Fortinbra/CHIRBot/host/chirbot-cli/README.md

# chirbot-cli

> **Status:** planned — no code yet.

Command-line tooling for CHIRBot, aimed at scripting and CI:

- Device configuration and firmware/asset management from scripts
- TASD file inspection, validation, and conversion
- Automated test harness support (streaming recorded input, capturing output)

See [docs/ARCHITECTURE.md](../../docs/ARCHITECTURE.md).
