Fortinbra/CHIRBot/firmware/modules/input-usb/README.md

# input-usb

> **Status:** planned — no code yet.

USB host input module (PIO-based USB host on RP2350B). Reads native USB
controllers and forwards input as TASD-packetized SPI data to the core.

Target devices include Xbox 360/PS3 controllers, wired Switch Pro controllers,
and accessibility hardware such as the Xbox Adaptive Controller and the Sony
PlayStation Access controller.

See [firmware/modules/README.md](../README.md) and
[docs/ARCHITECTURE.md](../../../docs/ARCHITECTURE.md).
