Fortinbra/CHIRBot/docs/ROADMAP.md

# CHIRBot roadmap

> **Status:** Working plan. Ordering may change as prototypes invalidate
> assumptions; accepted technical choices belong in [design decisions](design/).

The immediate goal is not to implement every planned component. It is to prove
one complete input-to-output path, exercise it on real hardware, and capture
the gotchas that shape the contracts for later modules. Performance targets are
measurements and follow-up work during this phase, not gates that block basic
integration.

## 0. Align the project baseline

- [ ] Update chirbot.com to reflect RP2350B, the passive module carrier, and
      board-to-board module slots;
      keep the longer design discussions as clearly labeled historical context
- [ ] Choose hardware, documentation, and contribution licenses explicitly
- [ ] Add contribution and security guidance before inviting broad contributions
- [ ] Establish lightweight CI for documentation links and the TASD host tests

## 1. Stabilize shared interfaces

- [ ] Define the [module interface](specs/README.md): connector pinout, power
      budget, mechanical envelope, retention, power-off-only/hot-swap policy,
      module descriptor fields, shared SPI/I2C rules, and per-slot CS/IRQ
- [ ] Define the [SPI matrix protocol](specs/README.md): framing, transactions,
      core-initiated discovery, descriptor encoding, data-ready service,
      capabilities, version negotiation, error handling, and timing
- [ ] Define CHIRBot's [TASD usage](specs/README.md), separating live transport
      needs from file-storage semantics
- [ ] Define the [clock-domain model](specs/README.md), including output poll
      edges, buffering, timestamps, and recording behavior
- [ ] Record the approximately 1 ms objective and the measurements needed to
      turn it into a later latency budget; do not make the final budget a PoC
      entry gate

## 2. Prove one vertical slice

- [ ] Select the simplest representative input/core/output combination
- [ ] Build a host-testable `chirbot-common` framing and handshake library
- [ ] Build the [three-MCU architecture prototype](../hardware/PROTOTYPE.md)
      using an RP2350B core and two modules on development hardware
- [ ] Demonstrate live relay, recording, and playback through the same path
- [ ] Verify the complete path, startup/reset behavior, link recovery, and
      replay behavior on real hardware
- [ ] Capture electrical margins, wiring mistakes, signal-integrity issues,
      and other hardware gotchas as prototype findings
- [ ] Measure latency and jitter as characterization data; optimize and enforce
      targets after the integration path is stable
- [ ] Feed prototype findings back into specs and superseding ADRs

NES/SNES is a strong candidate for this milestone because its signaling and
poll edge are well understood, but that selection should be recorded before
implementation begins.

## 3. Productize the proven path

- [ ] Design the core and first module PCBs from the stabilized interface
- [ ] Select a carrier topology for boot-selected dual-role modules, then
      design and validate the passive carrier PCB
- [ ] Add repeatable firmware builds, tests, release artifacts, and flashing docs
- [ ] Implement the minimum host configuration and TASD inspection workflow
- [ ] Validate cost targets with sourced BOMs and small production quantities
- [ ] Document assembly, enclosure, recovery, and troubleshooting workflows

## 4. Expand deliberately

- [ ] Add modules one protocol family at a time using the stable shared contracts
- [ ] Add visualization and richer host application workflows
- [ ] Propose required rumble and motion extensions upstream to TASD
- [ ] Promote components to standalone repositories only when independent
      versioning, releases, or ownership provide a concrete benefit

## Definition of baseline readiness

The project has a credible PoC baseline when one end-to-end hardware path is
repeatable, its startup and recovery behavior are understood, important
electrical and integration gotchas are recorded, and the build and focused
tests run. Meeting the final timing budget, production contracts, and module
authoring experience are productization milestones built on that baseline.
