Fortinbra/CHIRBot/tools/README.md

# tools/

Project-wide development tooling: build/CI helpers, code generation, release
scripts, and other utilities that span multiple components.

> **Status:** empty — tooling is added as needs emerge.
