Fortinbra/CHIRBot/hardware/chirbot-core-hw/CHIRBot Core.kicad_sch

## KiCad design hardware/chirbot-core-hw/CHIRBot Core.kicad_sch (2026-10-18)

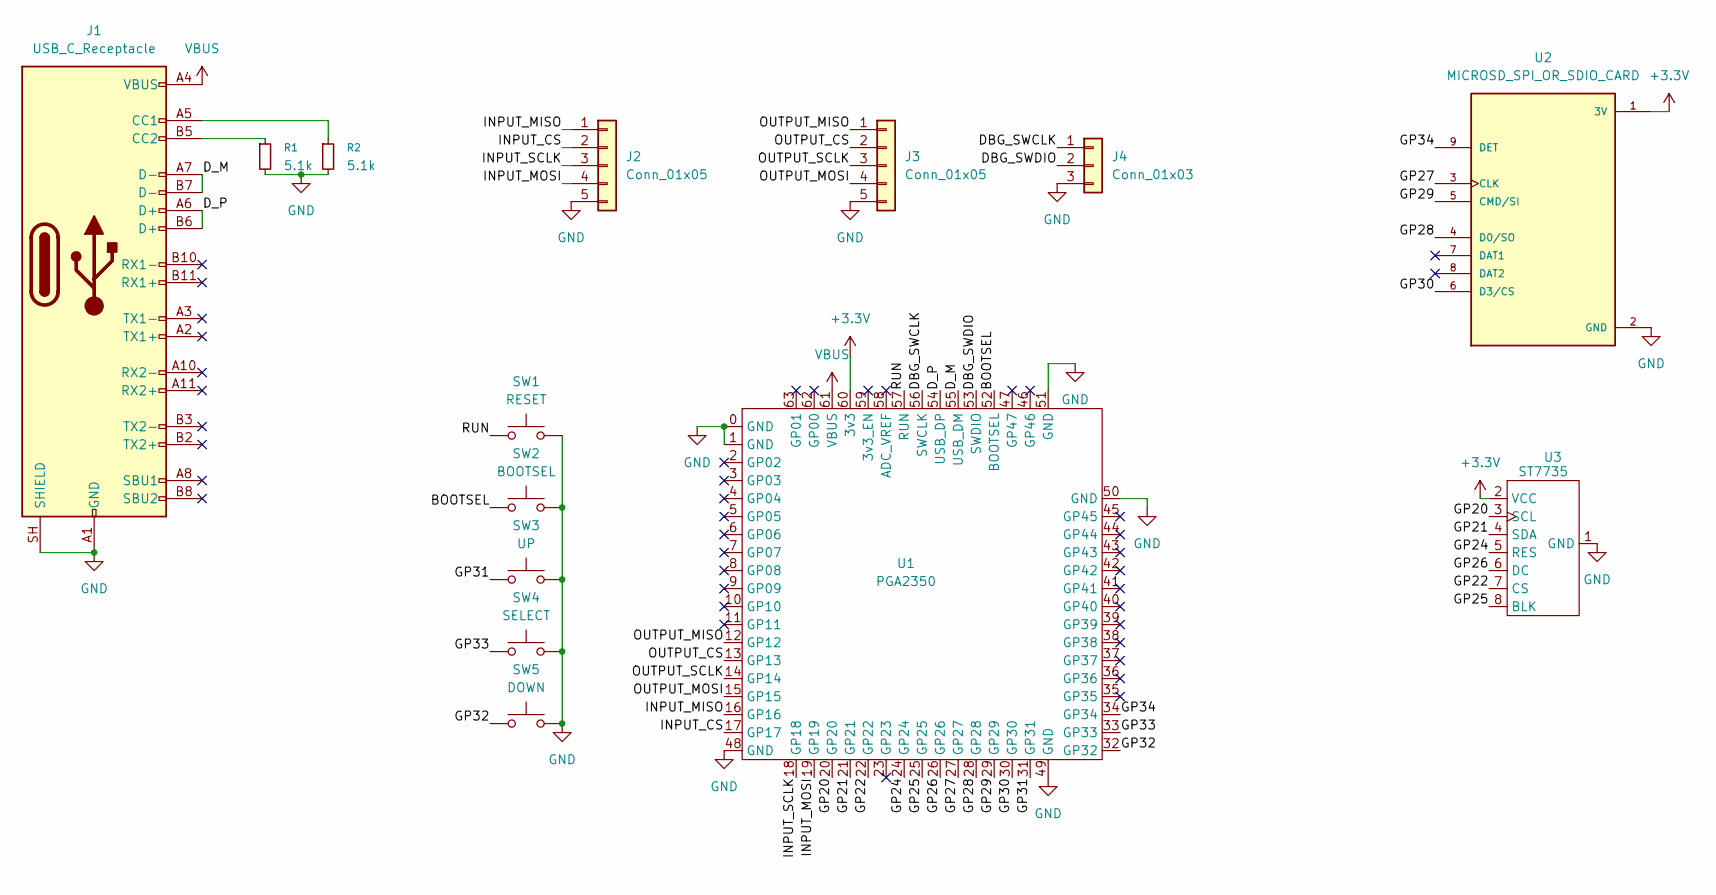
[picture p1: schematic CHIRBot Core.kicad_sch]

Parts:
J1: USB_C_Receptacle
J2, J3: Conn_01x05
J4: Conn_01x03
R1, R2: 5.1k
SW1: RESET
SW2: BOOTSEL
SW3: UP
SW4: SELECT
SW5: DOWN
U1: PGA2350
U2: MICROSD_SPI_OR_SDIO_CARD; MODULE_MICROSD_SPI_OR_SDIO_CARD; PARTREV B
U3: ST7735

Connections:
+3.3V: U1.60 (3v3), U2.1 (3V), U3.2 (VCC)
BOOTSEL: SW2.1, U1.52 (BOOTSEL)
DBG_SWCLK: J4.1, U1.56 (SWCLK)
DBG_SWDIO: J4.2, U1.53 (SWDIO)
D_M: J1.A7 (D-), J1.B7 (D-), U1.55 (USB_DM)
D_P: J1.A6 (D+), J1.B6 (D+), U1.54 (USB_DP)
GND: J1.A1 (GND), J1.A12 (GND), J1.B1 (GND), J1.B12 (GND), J1.SH (SHIELD), J2.5, J3.5, J4.3, R1.2, R2.2, SW1.2, SW2.2, SW3.2, SW4.2, SW5.2, U1.0 (GND), U1.1 (GND), U1.48 (GND), U1.49 (GND), U1.50 (GND), U1.51 (GND), U2.2 (GND), U3.1 (GND)
GP20: U1.20 (GP20), U3.3 (SCL)
GP21: U1.21 (GP21), U3.4 (SDA)
GP22: U1.22 (GP22), U3.7 (CS)
GP24: U1.24 (GP24), U3.5 (RES)
GP25: U1.25 (GP25), U3.8 (BLK)
GP26: U1.26 (GP26), U3.6 (DC)
GP27: U1.27 (GP27), U2.3 (CLK)
GP28: U1.28 (GP28), U2.4 (D0/SO)
GP29: U1.29 (GP29), U2.5 (CMD/SI)
GP30: U1.30 (GP30), U2.6 (D3/CS)
GP31: SW3.1, U1.31 (GP31)
GP32: SW5.1, U1.32 (GP32)
GP33: SW4.1, U1.33 (GP33)
GP34: U1.34 (GP34), U2.9 (DET)
INPUT_CS: J2.2, U1.17 (GP17)
INPUT_MISO: J2.1, U1.16 (GP16)
INPUT_MOSI: J2.4, U1.19 (GP19)
INPUT_SCLK: J2.3, U1.18 (GP18)
unnamed: J1.A5 (CC1), R2.1
unnamed: J1.B5 (CC2), R1.1
OUTPUT_CS: J3.2, U1.13 (GP13)
OUTPUT_MISO: J3.1, U1.12 (GP12)
OUTPUT_MOSI: J3.4, U1.15 (GP15)
OUTPUT_SCLK: J3.3, U1.14 (GP14)
RUN: SW1.1, U1.57 (RUN)
VBUS: J1.A4 (VBUS), J1.A9 (VBUS), J1.B4 (VBUS), J1.B9 (VBUS), U1.61 (VBUS)
