Fortinbra/CHIRBot/(commit log)

2026-04-18 Scribe: Merge agent decisions and update squad memory
    - Write orchestration logs for Slippy, Falco, Peppy (2026-04-18T23:55:43Z)
    - Write session log for copilot-instructions integration
    - Merge decision inbox (Copilot Instructions, Build Workflow, Validation Guidance) into decisions.md
    - Delete merged inbox files
    - Update agent histories with cross-agent context:
    - Slippy: Falco/Peppy platform and validation insights
    - Falco: Slippy firmware guidance and Peppy validation approach
    - Peppy: Slippy architecture and Falco platform confirmation
    All three agents completed parallel discovery of CHIRBot firmware project structure,
    build system (CMake + Ninja + Pico SDK 2.2.0), and validation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
2026-07-08 Add architecture doc, repo structure, TASD submodule, and gitignore
    - docs/ARCHITECTURE.md: system architecture and repository structure
    - Component folder structure with READMEs (firmware, hardware, host, tools)
    - firmware/TASD: Fortinbra/TASD library as a git submodule
    - .gitignore covering C/C++, CMake, Pico SDK, KiCad, VS Code, Python, .NET
2026-07-08 Refine architecture and documentation for module docking and SPI transport
2026-09-04 Enhance documentation with new specifications, roadmap, and prototype details; update existing files for clarity and structure
2026-09-10 Implement NES/SNES input module with project skeleton, PIO, SPI, and TASD integration
2026-09-11 feat: Implement NES-to-UART prototype with TASD integration
    - Updated TASD usage documentation to reflect prototype mapping for NES-to-UART scenario.
    - Added shared libraries for TASD and chirbot-common to firmware CMake configuration.
    - Enhanced chirbot-common with SPI link framing implementation.
    - Developed core firmware for CHIRBot, including SPI-to-UART relay functionality.
    - Created NES/SNES input module to poll NES controllers and emit TASD events.
    - Established SPI communication between input module and core, handling TASD packets.
    - Introduced a new end-to-end acceptance scenario for NES controller to core UART.
    - Implemented chirbot link protocol for frame encoding and decoding.
    -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
2026-09-13 Refactor hardware documentation and add new module carrier design
    - Updated README.md files for hardware components to reflect the current status and design details.
    - Added detailed descriptions for the CHIRBot core and module carrier hardware.
    - Introduced a new design document for the carrier and multislot bus topology, outlining the architecture and responsibilities.
    - Implemented new firmware for controller TASD encoding and decoding, including comprehensive tests for functionality and error handling.
    - Created a new test suite for the controller pipeline to ensure data integrity and proper handling of various scenarios.
    [controller_tasd.c, controller_tasd.h, main.cpp, nes_input_module.cpp, nes_input_module.hpp, output_module_config.hpp, tasd_wrapper.cpp]
2026-09-19 feat: Enhance input handling and display features
    - Added terminology section to documentation for clarity on input events.
    - Introduced SPI subnode library for improved SPI communication between modules.
    - Integrated ST7735 display support for on-device configuration with a rainbow splash screen.
    - Implemented demo functionality in NES input module to simulate button presses.
    - Updated CMake configurations to include new source files and libraries.
    - Enhanced output module to print button states in a user-friendly format.
    - Improved wiring documentation for clarity on display and module connections.
2026-09-19 feat: Update SPI handling and improve module communication reliability
2026-09-21 Add SD card probing and storage functionality
    - Implemented sd_probe.cpp to handle SD card communication, including initialization, command handling, and data transfer.
    - Added functions for reading and writing blocks, detecting filesystems, and parsing card capacity.
    - Created sd_storage.cpp to manage FAT filesystem operations, including mounting, formatting, and file reading.
    - Integrated disk I/O functions for compatibility with the FatFs library.
2026-10-05 feat: Update NES/SNES module pin configurations and documentation for improved clarity
2026-10-18 Add microSD module footprint and update documentation
    - Created a new footprint for the microSD SPI/SDIO card in the KiCad library.
    - Enhanced the README.md for the CHIRBot core board to clarify the module carrier's design decisions and dependencies.
    - Introduced a new symbol library table for the CHIRBot module.
    - Revised the NES/SNES module README to reflect the dual-role design and updated pin assignments for the consolidated module interface.
